igi79/easyDRO/img/11140114_10206920190380807_8720892361887795190_n.jpg

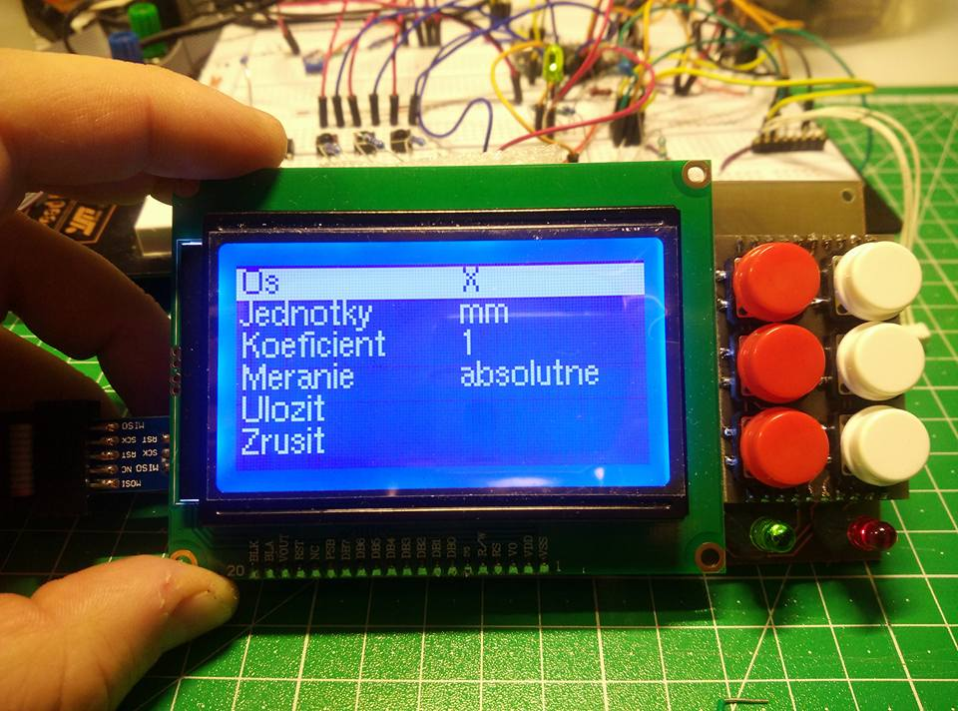
img/11140114_10206920190380807_8720892361887795190_n.jpg
