igi79/easyDRO/img/12644770_10206947591545819_1655489236746918448_n.jpg

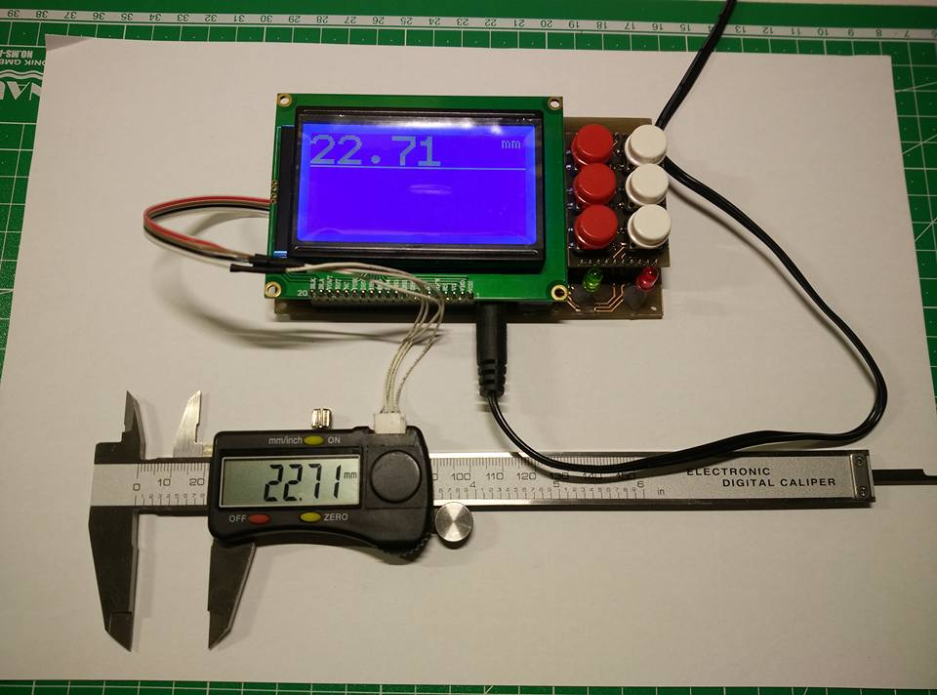
img/12644770_10206947591545819_1655489236746918448_n.jpg
