igi79/easyDRO/img/2016-01-24_20-03-11.png

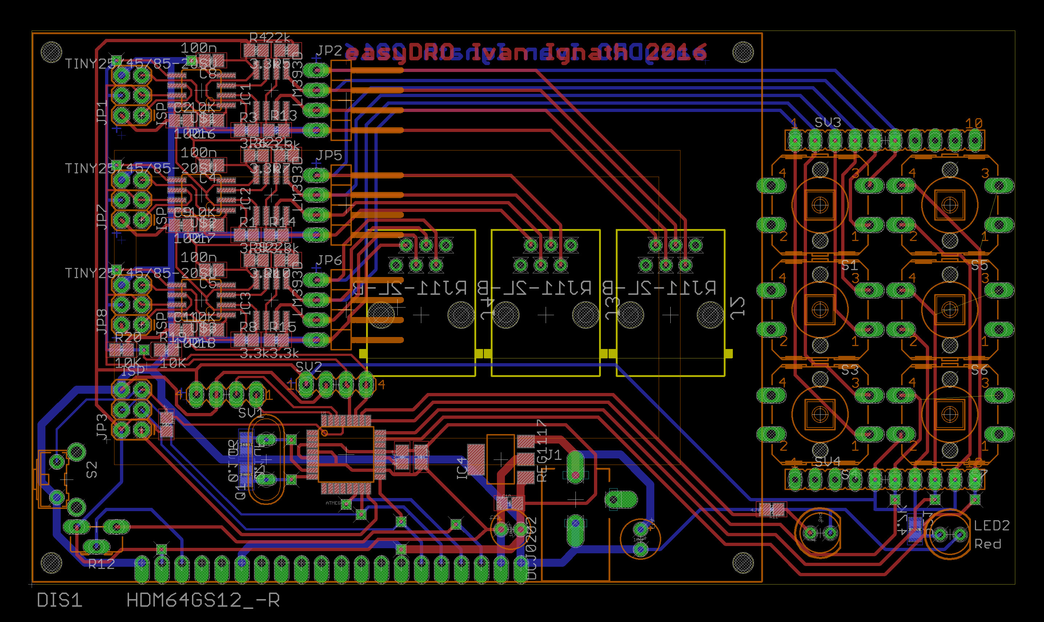
img/2016-01-24_20-03-11.png
