igi79/easyDRO/PCB/easyDRO.pdf

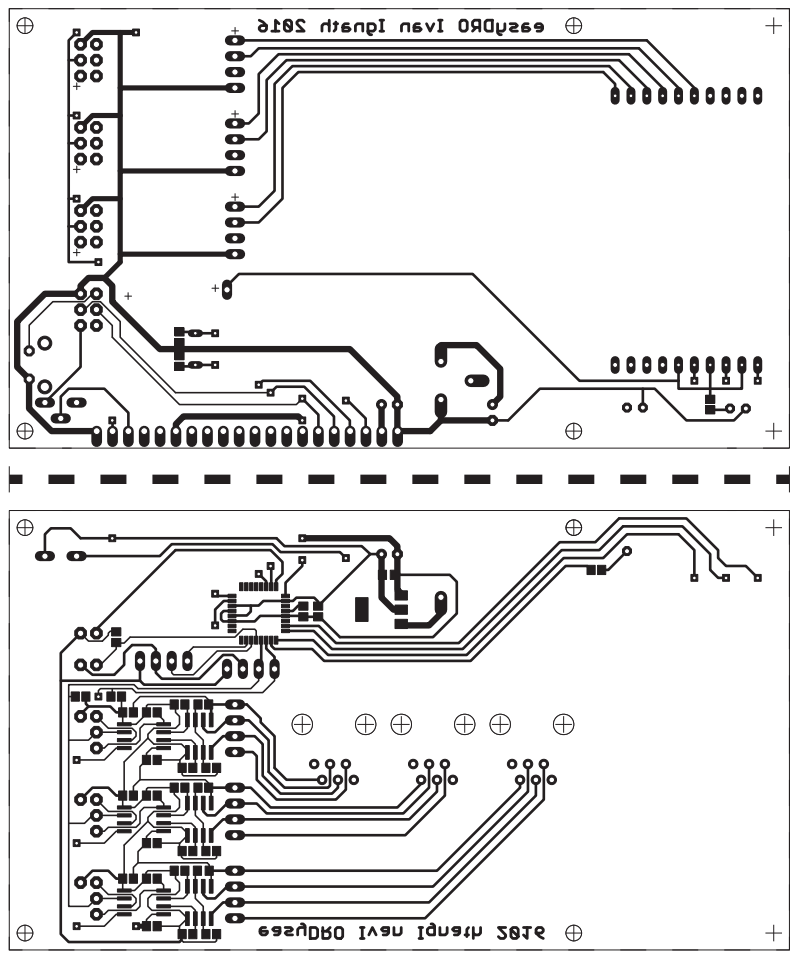
[picture p4: page 1]
