igi79/easyDRO/PCB/easyDRO_keys.pdf

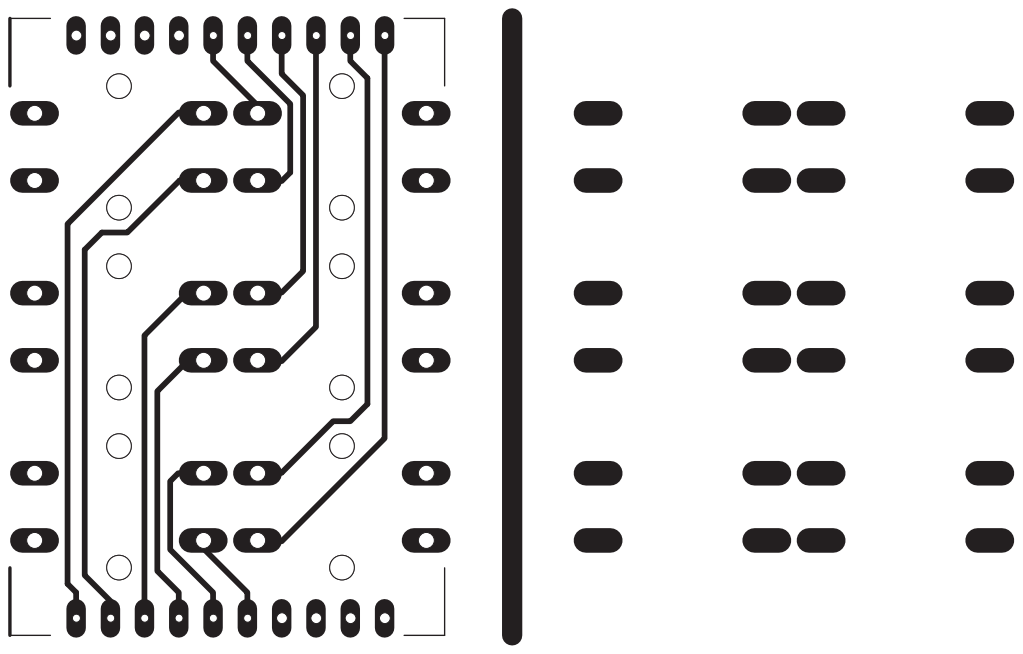
[picture p5: page 1]
