igi79/easyDRO/PCB/easyDRO_final.brd

## EAGLE design PCB/easyDRO_final.brd (2016-03-12)

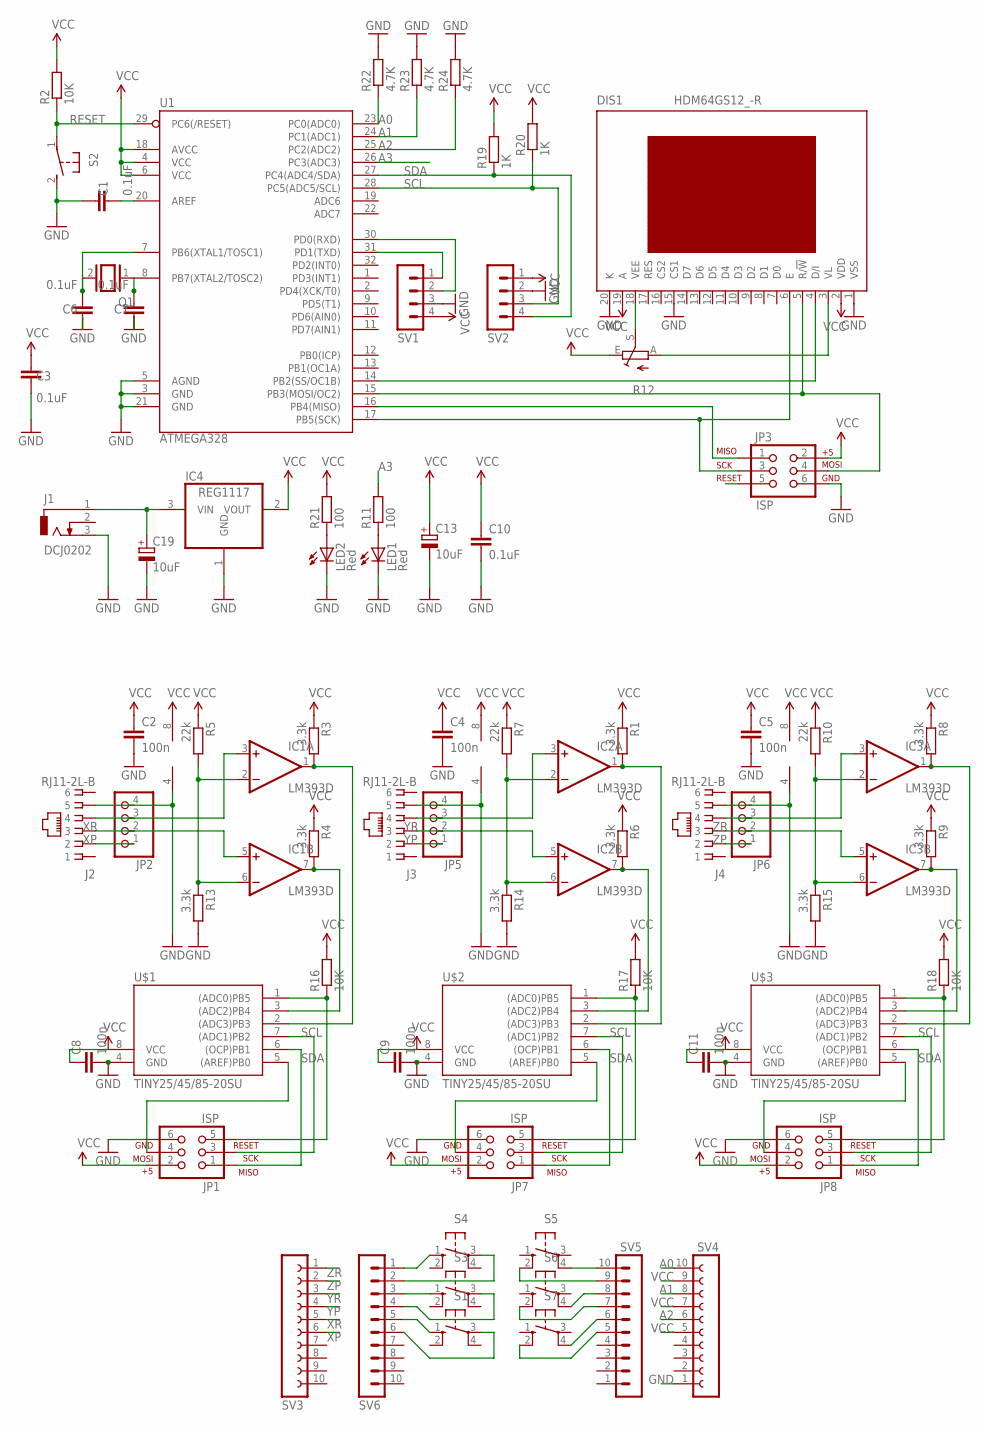
[picture p6: schematic easyDRO_final.sch]

Parts:
C1, C3, C6, C7, C10: 0.1uF; C0805
C2, C4, C5, C8, C9, C11: 100n; C0805
C13, C19: 10uF; E2,5-5
DIS1: HDM64GS12_-R
IC1, IC2, IC3: LM393D; SO08
IC4: REG1117; SOT223
J1: DCJ0202
J2, J3, J4: RJ11-2L-B; RJ11-NO_SHIELD
JP1, JP3, JP7, JP8: ISP; 2X3
JP2, JP5, JP6: PINHD-1X4/90; 1X04/90
LED1, LED2: Red; LED5MM
Q1: XTAL/S; QS
R1, R3, R4, R6, R8, R9, R13, R14, R15: 3.3k; R0805
R2, R16, R17, R18: 10K; R0805
R5, R7, R10: 22k; R0805
R11, R21: 100; R0805
R12: TRIM_EU-CA6H; CA6H
R19, R20: 1K; R0805
R22, R23, R24: 4.7K; R0805
S1, S3, S4, S5, S6, S7: 40-XX; B3F-40XX
S2: 31-XX; B3F-31XX
SV1, SV2: MA04-1
SV3, SV4: FE10-1; FE10
SV5, SV6: MA10-1
U1: ATMEGA328; TQFP32-08
U$1, U$2, U$3: TINY25/45/85-20SU; SOIC8

Connections:
A0: R22.1, SV4.10, U1.23 (PC0(ADC0))
A1: R23.1, SV4.8, U1.24 (PC1(ADC1))
A2: R24.1, SV4.6, U1.25 (PC2(ADC2))
A3: R11.2, U1.26 (PC3(ADC3))
CLK1: IC1.7 (OUT), R4.2, U$1.3 ((ADC2)PB4)
CLK2: IC2.7 (OUT), R6.2, U$2.3 ((ADC2)PB4)
CLK3: IC3.7 (OUT), R9.2, U$3.3 ((ADC2)PB4)
DATA1: IC1.1 (OUT), R3.2, U$1.2 ((ADC3)PB3)
DATA2: IC2.1 (OUT), R1.2, U$2.2 ((ADC3)PB3)
DATA3: IC3.1 (OUT), R8.2, U$3.2 ((ADC3)PB3)
GND: C1.2, C2.2, C3.1, C4.2, C5.2, C6.2, C7.2, C8.2, C9.2, C10.2, C11.2, C13.-, C19.-, DIS1.1 (VSS), DIS1.15 (CS1), DIS1.20 (K), IC1.4 (V-), IC2.4 (V-), IC3.4 (V-), IC4.1 (GND), J1.3, J2.5, J3.5, J4.5, JP1.6, JP2.4, JP3.6, JP5.4, JP6.4, JP7.6, JP8.6, LED1.K (C), LED2.K (C), R13.2, R14.2, R15.2, R22.2, R23.2, R24.2, S2.2 (S), SV1.3, SV2.2, SV4.1, U1.3 (GND), U1.5 (AGND), U1.21 (GND), U$1.4 (GND), U$2.4 (GND), U$3.4 (GND)
unnamed: IC1.2 (-IN), IC1.6 (-IN), R5.2, R13.1
unnamed: DIS1.6 (E), JP3.3, U1.17 (PB5(SCK))
unnamed: DIS1.5 (R/!W), JP3.4, U1.15 (PB3(MOSI/OC2))
unnamed: DIS1.4 (D/I), U1.14 (PB2(SS/OC1B))
unnamed: C7.1, Q1.1, U1.8 (PB7(XTAL2/TOSC2))
unnamed: C1.1, U1.20 (AREF)
unnamed: C6.1, Q1.2, U1.7 (PB6(XTAL1/TOSC1))
unnamed: JP1.1, U$1.6 ((OCP)PB1)
unnamed: JP1.5, R16.1, U$1.1 ((ADC0)PB5)
unnamed: JP7.1, U$2.6 ((OCP)PB1)
unnamed: JP7.5, R17.1, U$2.1 ((ADC0)PB5)
unnamed: JP8.1, U$3.6 ((OCP)PB1)
unnamed: JP8.5, R18.1, U$3.1 ((ADC0)PB5)
unnamed: SV1.1, U1.31 (PD1(TXD))
unnamed: JP3.1, U1.16 (PB4(MISO))
unnamed: DIS1.18 (VEE), R12.S
unnamed: DIS1.3 (VL), R12.A
unnamed: S5.4 (P1), SV5.10
unnamed: IC1.3 (+IN), J2.4, JP2.3
unnamed: IC2.2 (-IN), IC2.6 (-IN), R7.2, R14.1
unnamed: S5.2 (S1), SV5.9
unnamed: SV1.2, U1.30 (PD0(RXD))
unnamed: LED2.A, R21.1
unnamed: S6.4 (P1), SV5.8
unnamed: IC2.3 (+IN), J3.4, JP5.3
unnamed: S6.2 (S1), SV5.7
unnamed: IC3.2 (-IN), IC3.6 (-IN), R10.2, R15.1
unnamed: S7.4 (P1), SV5.6
unnamed: S7.2 (S1), SV5.5
unnamed: S4.1 (S), SV6.1
unnamed: IC3.3 (+IN), J4.4, JP6.3
unnamed: S4.3, SV6.2
unnamed: S3.1 (S), SV6.3
unnamed: S3.3, SV6.4
unnamed: S1.1 (S), SV6.5
unnamed: S1.3, SV6.6
unnamed: LED1.A, R11.1
RESET: JP3.5, R2.1, S2.1, U1.29 (PC6(/RESET))
SCL: JP1.3, JP7.3, JP8.3, R20.1, SV2.3, U1.28 (PC5(ADC5/SCL)), U$1.7 ((ADC1)PB2), U$2.7 ((ADC1)PB2), U$3.7 ((ADC1)PB2)
SDA: JP1.4, JP7.4, JP8.4, R19.1, SV2.4, U1.27 (PC4(ADC4/SDA)), U$1.5 ((AREF)PB0), U$2.5 ((AREF)PB0), U$3.5 ((AREF)PB0)
VCC: C2.1, C3.2, C4.1, C5.1, C8.1, C9.1, C10.1, C11.1, C13.+, DIS1.2 (VDD), DIS1.19 (A), IC1.8 (V+), IC2.8 (V+), IC3.8 (V+), IC4.2 (VOUT), JP1.2, JP3.2, JP7.2, JP8.2, R1.1, R2.2, R3.1, R4.1, R5.1, R6.1, R7.1, R8.1, R9.1, R10.1, R12.E, R16.2, R17.2, R18.2, R19.2, R20.2, R21.2, SV1.4, SV2.1, SV4.5, SV4.7, SV4.9, U1.4 (VCC), U1.6 (VCC), U1.18 (AVCC), U$1.8 (VCC), U$2.8 (VCC), U$3.8 (VCC)
VIN: C19.+, IC4.3 (VIN), J1.1
XP: J2.2, JP2.1, SV3.6
XR: IC1.5 (+IN), J2.3, JP2.2, SV3.5
YP: J3.2, JP5.1, SV3.4
YR: IC2.5 (+IN), J3.3, JP5.2, SV3.3
ZP: J4.2, JP6.1, SV3.2
ZR: IC3.5 (+IN), J4.3, JP6.2, SV3.1

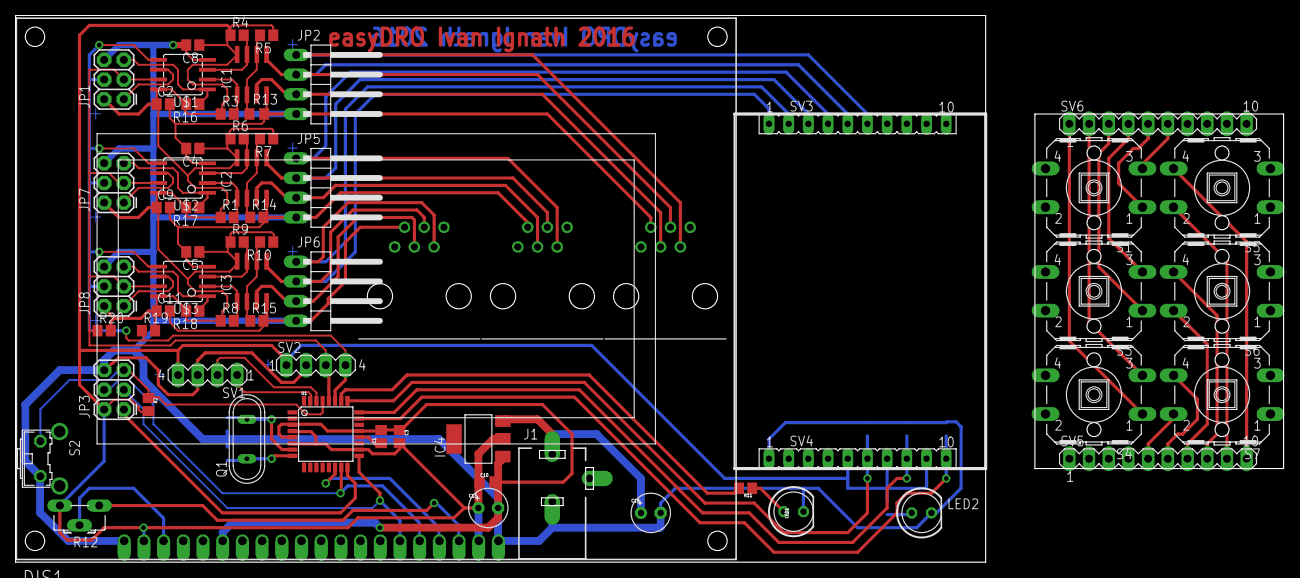
[picture p7: board easyDRO_final.brd from above]

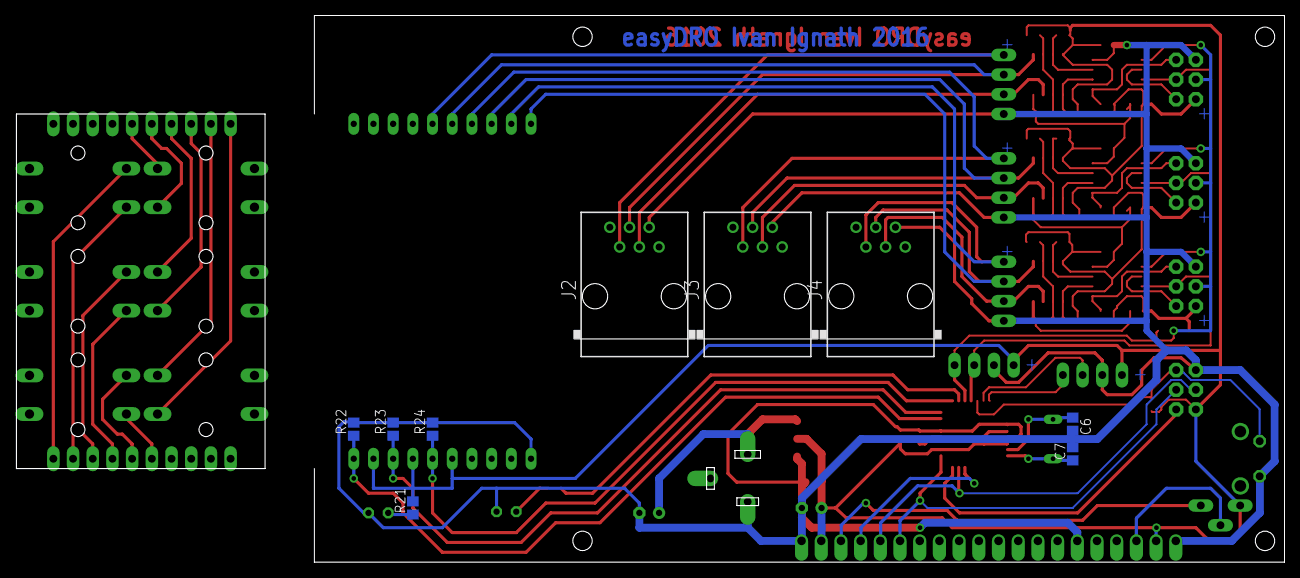
[picture p8: board easyDRO_final.brd from below]

Board: 2 copper layers, 163.5 x 70.5 mm, 73 parts (9 on the bottom side), 59 nets.
